fernandoaestrella/Electrocardiogram/(list of files, drawings)

Other design files:
Electrocardiogram/ECG1/ecg.ms11
Electrocardiogram/ecg/ecg.ms11
